LimaJuliett/Switch-Panel/images/LED_Mount_1.jpg

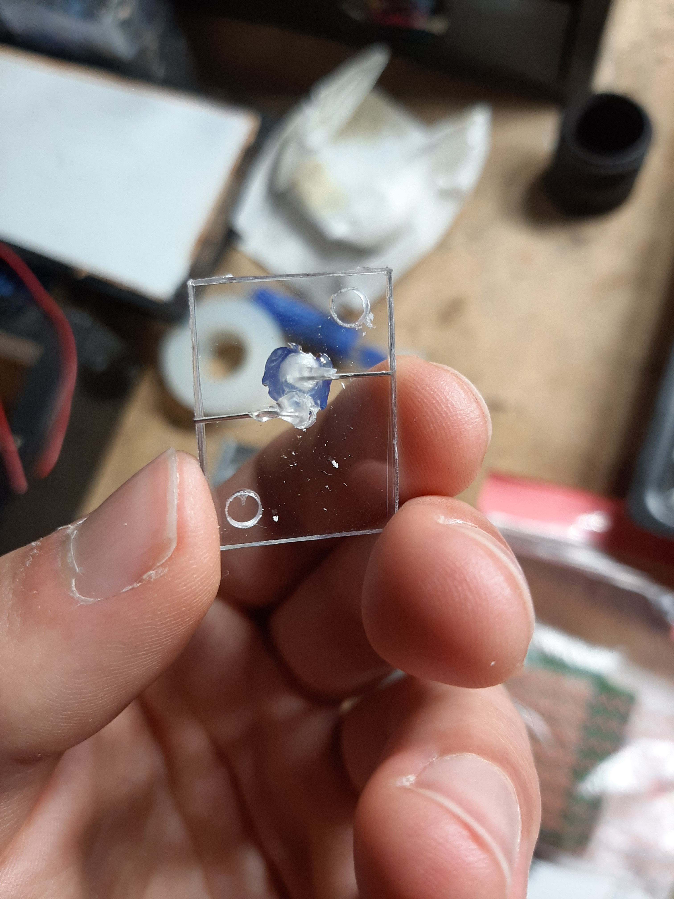
images/LED_Mount_1.jpg
