LimaJuliett/Switch-Panel/images/LED_Mount_2.jpg

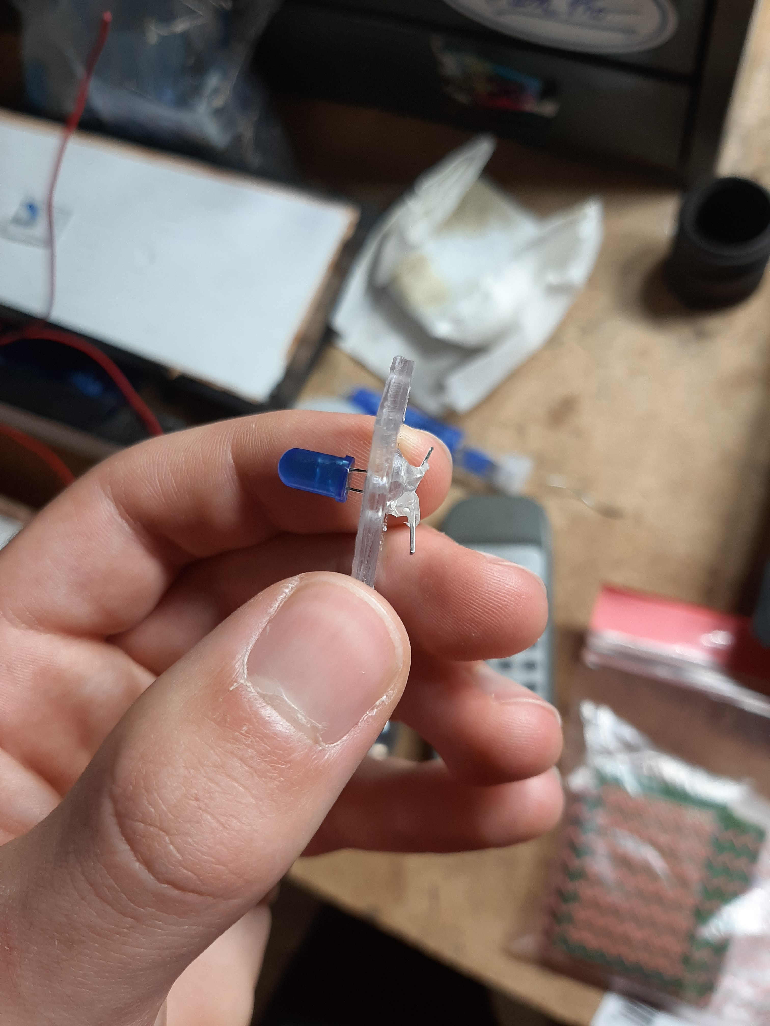
images/LED_Mount_2.jpg
