LimaJuliett/Switch-Panel/images/LED_Mount_4.jpg

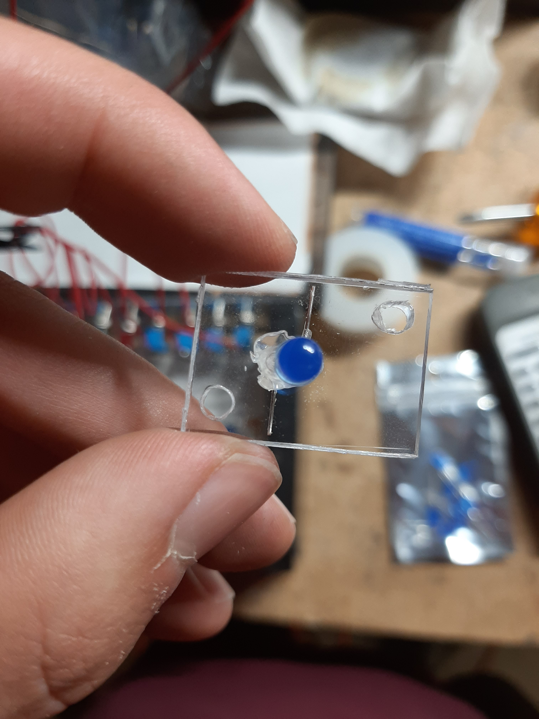
images/LED_Mount_4.jpg
