LimaJuliett/Switch-Panel/images/LED_Mount_5.jpg

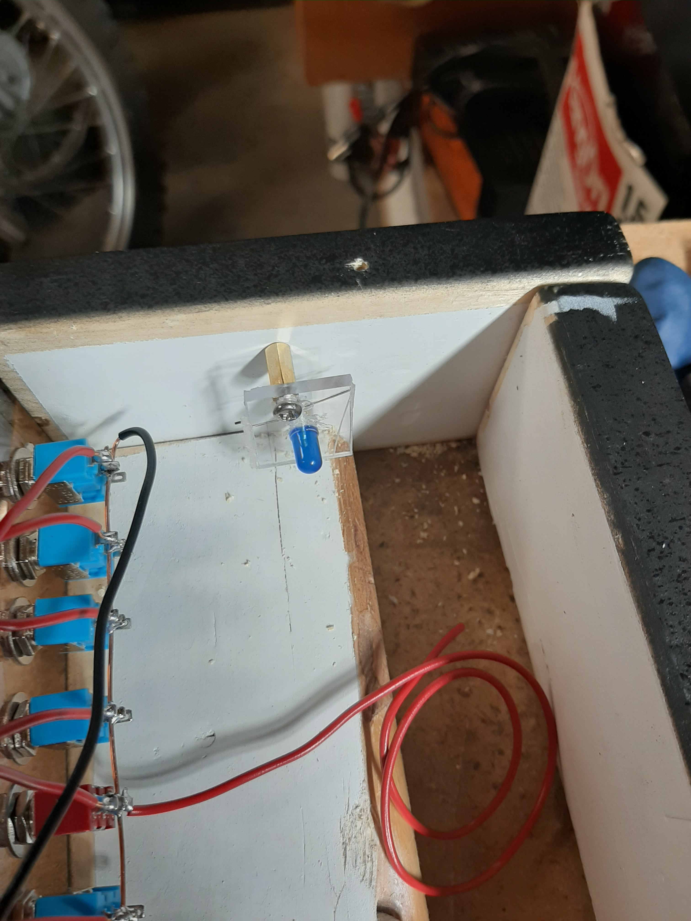
images/LED_Mount_5.jpg
