LimaJuliett/Switch-Panel/images/LED_Mount_6.jpg

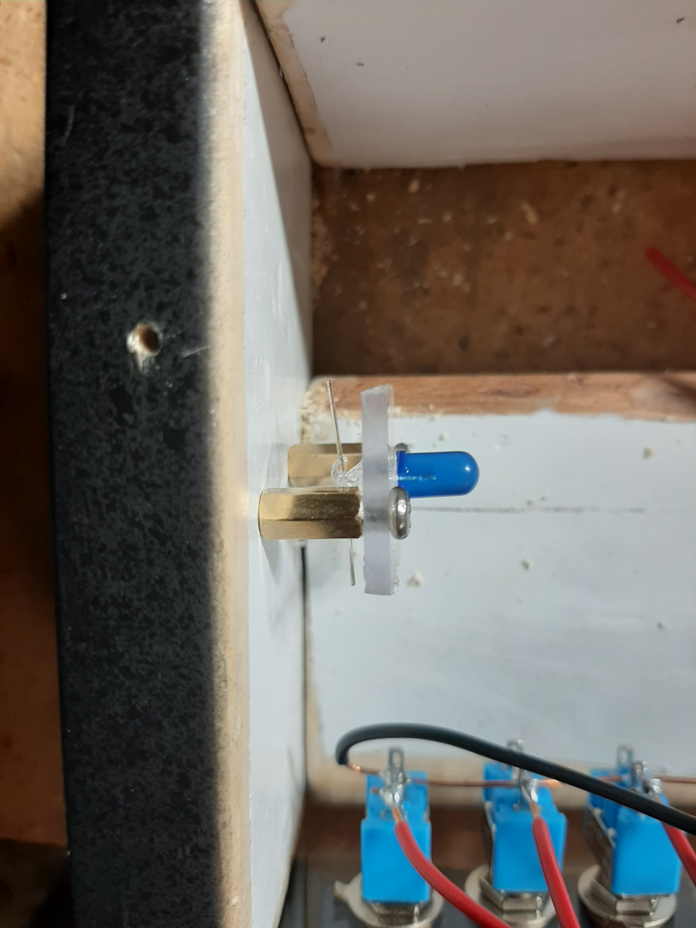
images/LED_Mount_6.jpg
