LimaJuliett/Switch-Panel/images/No_Lid_1.jpg

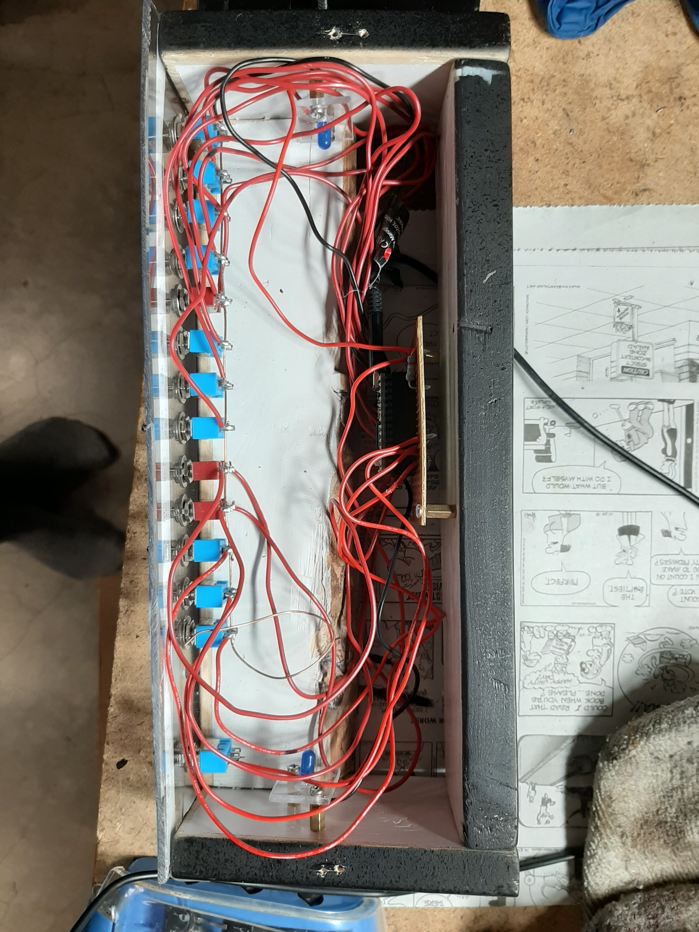
images/No_Lid_1.jpg
